hevrosy/neuromorphic-enose-fpga/cadfiles/README.md

# Advanced E-Nose Fluidic Chamber
## Dual-Loop Parametric Measurement Chamber for Gas-Sensor Arrays

**Project:** Neuromorphic e-Nose on FPGA  
**Repository section:** `cadfiles/`  
**CAD model:** `enose_chamber_parametric.scad`  
**Architecture version:** 1.2.4  
**Target application:** Electronic-nose data acquisition, VOC sampling, gas-sensor array stabilization, and machine-learning dataset generation  
**Primary manufacturing method:** FDM 3D printing  
**Target fan:** Sunon EE60201B1 or mechanically compatible high-speed 60 mm axial fan  

---

## 1. Overview

This directory contains the parametric CAD design for a custom fluidic measurement chamber developed as part of the **Neuromorphic e-Nose on FPGA** project. The chamber is designed for repeatable acquisition of gas-sensor time-series data from volatile organic compounds emitted by food samples or other analyte sources.

The chamber is not a simple enclosure. It is a controlled fluidic interface between the physical sample, the gas-sensor array, and the data-acquisition pipeline. Its purpose is to reduce common sources of experimental variability in low-cost electronic-nose systems, including uncontrolled turbulence, stagnant zones, thermal drift, sensor-to-sensor exposure imbalance, vibration transfer, and adsorption memory effects.

The current CAD implementation is provided as a fully parametric OpenSCAD model. It includes the main flow chamber, sensor plate, honeycomb diffuser, aerodynamic lid, fan dome, TPU gaskets, fan-isolation elements, purge plug, vibration-damping washers, and shock-absorbing feet.

---

## 2. Design Motivation

Low-cost electronic-nose systems based on metal-oxide semiconductor gas sensors are highly sensitive to the geometry and dynamics of the measurement chamber. Even when the same sensors and electronics are used, the acquired data can vary significantly depending on airflow, sample position, chamber volume, temperature distribution, and residual contamination from previous measurements.

The chamber was designed to address the following problems:

1. **Poor gas mixing**  
   Box-shaped chambers often create stagnant zones where analyte concentration changes slowly and non-uniformly.

2. **Aerodynamic noise**  
   Turbulent eddies near the sensor surface can create local pressure and concentration fluctuations that appear as noise in the sensor response.

3. **Thermal drift**  
   MQ-series sensors rely on heated metal-oxide surfaces. Excessive or unstable airflow can disturb the thermal equilibrium of the sensing layer and shift the baseline.

4. **Sensor exposure imbalance**  
   If the gas front reaches different sensors at different times or concentrations, the dataset may encode chamber artifacts rather than chemical information.

5. **Memory effect**  
   VOC molecules can adsorb to untreated 3D-printed polymer surfaces and desorb slowly in later runs, contaminating the baseline.

6. **Vibration coupling**  
   Fan-induced vibration can be mechanically transferred to the sensor plate and wiring, increasing analog measurement noise.

The proposed design uses a dual-loop fluidic architecture to separate high-energy internal mixing from low-flow sample extraction and sensor exposure.

---

## 3. System-Level Role in the e-Nose Project

The chamber is the physical front end of the full neuromorphic e-nose pipeline:

```text
Food or analyte sample
        ↓
Headspace vial / sample source
        ↓
Passive sample transport through PTFE tubing
        ↓
Fluidic chamber and gas-sensor array
        ↓
Raw sensor time-series acquisition
        ↓
Baseline correction and preprocessing
        ↓
Delta-based spike encoding
        ↓
SNN training and weight quantization
        ↓
FPGA SNN inference on PYNQ-Z2 / Zynq-7020
```

The chamber is therefore not only a mechanical part. It is a dataset-quality component. Its design affects the signal-to-noise ratio, temporal repeatability, sensor drift, and reliability of the training data used by the spiking neural network.

---

## 4. Fluidic Architecture

The chamber uses a **dual-loop fluidic architecture**:

1. **Primary internal loop**  
   A high-flow internal circulation loop driven by the axial fan. Its role is to rapidly homogenize the air volume inside the chamber.

2. **Secondary sampling loop**  
   A low-flow passive extraction path that transports analyte from an external headspace vial into the chamber through PTFE tubing. Its role is to introduce the sample gas at a controlled rate without disturbing the thermal stability of the sensors.

This separation allows the chamber to combine fast mixing with gentle sensor exposure.

---

## 5. Primary Loop: Internal Mixing and Homogenization

The primary loop is generated by a high-speed axial fan mounted in the upper section of the chamber. Instead of blowing directly onto the sensor array, the fan output is routed through tangential ducts integrated into the aerodynamic lid.

These tangential ducts inject air along the chamber walls, producing a controlled cyclonic flow. The purpose of this flow is to homogenize the chamber volume and reduce concentration gradients.

The design model assumes:

| Parameter | Design Estimate |
|---|---:|
| Main chamber volume | approximately 1.2 L |
| Operating pressure differential | approximately 39 Pa |
| Engineered choke diameter | 6.5 mm |
| Primary internal flow estimate | approximately 40 L/min |
| Approximate chamber volume exchanges | approximately 33 per minute |

These values are analytical design estimates derived from the geometry and simplified fluid-dynamic assumptions. They should be experimentally verified using flow or pressure measurements if used as final metrological data.

---

## 6. Honeycomb Diffuser and Flow Laminarization

Although the primary vortex improves mixing, turbulent flow directly over metal-oxide sensors is undesirable. The chamber therefore includes a **40 mm honeycomb diffuser insert**. The diffuser acts as a geometric flow straightener.

Its purpose is to:

- break the large-scale vortex into many small parallel channels;
- suppress transverse velocity components;
- reduce local turbulence near the sensing surface;
- produce a more uniform cross-flow over the sensor plate;
- improve the repeatability of the transient response.

The OpenSCAD model implements this diffuser as a drop-in honeycomb structure with integrated mounting pillars. The honeycomb geometry is intended to reduce the effective hydraulic diameter of the flow paths and promote more stable flow conditions before the gas reaches the sensors.

---

## 7. Secondary Loop: Passive Sample Extraction

The secondary loop transports analyte from an external headspace vial to the chamber through a chemically inert PTFE tube. This avoids placing the food sample directly on the sensor plate and makes the measurement more repeatable.

The current design documentation assumes:

| Parameter | Design Value |
|---|---:|
| Headspace vial volume | approximately 115 mL |
| PTFE tube internal radius | 1 mm |
| PTFE tube length | approximately 0.4 m |
| Driving pressure differential | approximately 39 Pa |
| Estimated sampling flow | approximately 127 mL/min |
| Approximate vial exchange time | approximately 54 s |

The sampling flow is estimated using the Hagen–Poiseuille equation for laminar flow in a cylindrical tube:

\[
Q = \frac{\Delta P \cdot \pi r^4}{8 \mu L}
\]

where \(\Delta P\) is the pressure differential, \(r\) is the tube radius, \(\mu\) is the dynamic viscosity of air, and \(L\) is the tube length.

A key design feature is the fourth-power dependence on tube radius. Small changes in tube diameter can strongly affect the sampling flow. For this reason, the tubing diameter and length should be kept fixed between experiments.

---

## 8. Sensor Thermodynamics

MQ-series gas sensors use heated metal-oxide surfaces, commonly based on tin dioxide. Their response depends on surface reactions between adsorbed oxygen species and reducing gases. The heater temperature strongly affects adsorption, desorption, surface conductivity, and baseline resistance.

A major risk in electronic-nose chambers is convective cooling of the sensor surface. If the gas flow over the sensing layer is too strong or unstable, the sensor baseline may shift because of thermal effects rather than analyte concentration.

The chamber therefore separates the high-flow mixing loop from the low-flow sample-exposure loop. The primary loop homogenizes the chamber, while the secondary loop introduces sample gas at a restricted flow rate. This helps reduce thermal disturbance of the sensor micro-heaters.

---

## 9. Vibration Isolation

The design includes several TPU-based viscoelastic elements:

- lid gaskets;
- fan isolation gasket;
- fan suspension gasket;
- TPU washers;
- shock-absorbing base feet;
- purge plug.

These components serve two purposes:

1. **Airtight sealing**  
   TPU gaskets improve hermetic sealing between printed rigid parts.

2. **Mechanical decoupling**  
   TPU elements reduce vibration transfer from the fan to the chamber body and sensor plate.

This is important because mechanical vibration can couple into wiring, sensor boards, connectors, and analog front-end electronics.

---

## 10. Surface Passivation and Memory Effect

FDM-printed polymer surfaces are not ideal analytical surfaces. They may contain layer lines, pores, roughness, and chemically active sites. VOC molecules can adsorb to these surfaces and slowly desorb during later measurements, creating a memory effect.

For scientific experiments, the inner surfaces of the chamber should be passivated. A thin layer of chemically resistant, low-outgassing, low-surface-energy coating can reduce adsorption and improve recovery between runs.

Recommended passivation targets:

- internal wall of the main flow chamber;
- internal lid surfaces;
- sample gas pathway;
- surfaces exposed to analyte-rich gas.

The passivation process should be documented in the experimental protocol because it directly affects dataset repeatability.

---

## 11. Purge Protocol

The chamber includes a purge feature that allows rapid removal of residual analyte between experiments. The purge plug can be opened to reduce the aerodynamic impedance and allow high-flow flushing with room air.

A purge cycle is required between measurement runs to:

- remove residual VOCs;
- restore the sensor baseline;
- reduce cross-contamination;
- improve repeatability;
- avoid temporal leakage between sample classes.

A conservative measurement protocol should include a fixed purge duration, even if the analytical estimate suggests fast volume exchange.

Recommended practical purge procedure:

```text
1. Remove or isolate the previous sample.
2. Open the purge path.
3. Run the fan for a fixed purge duration.
4. Monitor sensor baseline recovery.
5. Start the next run only after the baseline stabilizes.
```

For publication-quality experiments, the purge time should be determined experimentally from baseline recovery curves rather than only from theoretical airflow estimates.

---

## 12. CAD Model Structure

The file `enose_chamber_parametric.scad` contains the full parametric chamber model.

The OpenSCAD model supports several rendering and export modes through the `view_mode` parameter:

```scad
view_mode = "print_layout";
```

Available modes:

| Mode | Description |
|---|---|
| `assembly` | Full exploded assembly view |
| `print_layout` | All parts arranged on the build plate |
| `part_base` | Export the main flow chamber base |
| `part_plate` | Export the universal sensor plate |
| `part_diffuser` | Export the honeycomb diffuser |
| `part_lid` | Export the aerodynamic lid |
| `part_dome` | Export the wide-body fan dome |
| `tpu_lid_gaskets` | Export main TPU sealing gaskets |
| `tpu_purge_plug` | Export the ergonomic purge plug |
| `tpu_fan_gasket` | Export the fan isolation gasket |
| `tpu_washers` | Export TPU dome bolt washers |
| `tpu_feet` | Export shock-absorbing base feet |

---

## 13. Main Printed Components

| Component | Function | Suggested Material |
|---|---|---|
| `flow_chamber` | Main 1.2 L chamber body with ports and standoffs | PETG / ABS / ASA |
| `sensor_plate` | Universal perforated plate for sensor mounting | PETG / ABS / ASA |
| `diffuser_insert` | 40 mm honeycomb flow straightener | PETG / ABS / ASA |
| `lid_pro` | Aerodynamic lid with tangential ducts and gasket grooves | PETG / ABS / ASA |
| `fan_dome_ultimate` | Wide-body fan dome with bypass cavity | PETG / ABS / ASA |
| `tpu_lid_gaskets` | Main airtight gaskets | TPU 95A |
| `tpu_purge_plug` | Manual purge valve plug | TPU 95A |
| `tpu_fan_gasket` | Fan vibration isolation gasket | TPU 95A |
| `tpu_washers` | Dome bolt vibration washers | TPU 95A |
| `tpu_feet` | Shock-absorbing chamber feet | TPU 95A |

---

## 14. Key Parametric Dimensions

The current OpenSCAD model uses the following main parameters:

| Parameter | Value | Description |
|---|---:|---|
| `fc_w` | 144 mm | Outer base width |
| `fc_l` | 144 mm | Outer base length |
| `fc_h` | 60 mm | Internal height of primary air column |
| `fc_r` | 15 mm | Outer corner radius |
| `wall_t` | 4.0 mm | Wall thickness |
| `bot_t` | 4.0 mm | Base floor thickness |
| `sp_mount_xy` | 100 mm | Sensor plate mounting hole spacing |
| `fan_size` | 62 mm | Fan footprint with tolerance |
| `fan_hole` | 58 mm | Active fan intake diameter |
| `fan_mount` | 25 mm | Fan mounting hole offset |
| `fan_thickness` | 20 mm | Target fan thickness |
| `tpu_t` | 1.2 mm | Fan isolation gasket thickness |
| `gasket_h` | 3.2 mm | Main gasket groove depth |
| `tol` | 0.2 mm | General print clearance tolerance |

These parameters can be modified to adapt the chamber to other fans, sensor plates, or manufacturing tolerances.

---

## 15. Manufacturing Recommendations

Recommended rigid materials:

- PETG;
- ABS;
- ASA.

Recommended flexible material:

- TPU 95A for gaskets, isolation washers, plug, and feet.

General printing recommendations:

| Parameter | Recommendation |
|---|---|
| Layer height | 0.16–0.24 mm |
| Perimeters | 4 or more |
| Infill | 25–40%, gyroid or cubic |
| Top/bottom layers | 5 or more |
| Rigid parts | PETG / ABS / ASA |
| Gaskets | TPU 95A |
| Supports | Designed to be support-free where possible |

For gas-sensing experiments, airtightness is more important than visual surface quality. Increase wall count if needed.

---

## 16. Bill of Materials

| Category | Item | Quantity | Notes |
|---|---|---:|---|
| Filament | PETG / ABS / ASA | approximately 300 g | Rigid parts |
| Filament | TPU 95A | approximately 10–20 g | Gaskets, washers, plug, feet |
| Fan | Sunon EE60201B1 or compatible 60 mm fan | 1 | High-speed axial fan |
| Inserts | M3 heat-set inserts | 12 pcs | For repeated assembly |
| Bolts | M3 bolts | as required | Lid, dome, diffuser mounting |
| Pneumatic fittings | PC4-M6 or compatible | 1–2 pcs | Sample tubing connection |
| Tubing | PTFE tube, 2 mm ID | approximately 0.4–0.5 m | Sample transport |
| Sealant/coating | Low-outgassing epoxy or compatible coating | as required | Surface passivation |

---

## 17. Assembly Overview

Recommended assembly sequence:

```text
1. Print rigid parts from PETG, ABS, or ASA.
2. Print TPU gaskets, fan gasket, washers, purge plug, and feet.
3. Install M3 heat-set inserts in the base and lid.
4. Mount the sensor plate inside the chamber.
5. Install the honeycomb diffuser above the sensor region.
6. Install the lid gasket and mount the aerodynamic lid.
7. Mount the fan between TPU isolation gaskets.
8. Install the fan dome and TPU washers.
9. Install PTFE tubing and pneumatic fittings.
10. Seal and passivate internal analyte-exposed surfaces if required.
11. Perform leak testing and purge testing.
12. Run baseline stability tests before collecting datasets.
```

---

## 18. Experimental Use

A recommended measurement run includes:

```text
1. Chamber purge
2. Baseline acquisition
3. Sample connection or sample exposure
4. Stabilization interval
5. Active recording interval
6. Sample removal
7. Post-run purge
8. Baseline recovery check
```

Recommended metadata for each run:

| Field | Description |
|---|---|
| `Run_ID` | Unique measurement run identifier |
| `Batch_ID` | Sample batch identifier |
| `Product` | Food or analyte type |
| `True_Class` | Experimental label, e.g. Fresh / Warning / Spoiled |
| `Timestamp` | Acquisition time |
| `Temperature` | Chamber or ambient temperature |
| `Humidity` | Relative humidity |
| `Purge_Time` | Purge duration before run |
| `Baseline_Duration` | Baseline acquisition duration |
| `Recording_Duration` | Active measurement duration |
| `Notes` | Experimental observations |

---

## 19. Integration With the Neuromorphic FPGA Pipeline

The chamber provides the physical data source for the full neuromorphic pipeline:

```text
Chamber measurement
        ↓
Raw sensor values
        ↓
Baseline-corrected values
        ↓
Temporal delta extraction
        ↓
Positive and negative spike channels
        ↓
12-bit spike masks
        ↓
SNN training dataset
        ↓
Quantized weights
        ↓
FPGA SNN inference
```

This makes the chamber an essential part of the system, not only an accessory. Any changes to chamber geometry, tubing length, fan speed, purge procedure, or surface coating may change the dataset distribution and should be documented.

---

## 20. Scientific Notes and Limitations

The current chamber design is based on analytical fluid-dynamic reasoning and parametric CAD implementation. The reported pressure, flow, and exchange-time values should be interpreted as design estimates unless independently measured.

Recommended validation steps:

- measure actual pressure differential;
- measure sample loop flow rate;
- measure purge recovery time;
- record baseline stability over time;
- compare sensor response with and without fan vibration isolation;
- evaluate repeatability across multiple runs;
- evaluate adsorption memory before and after surface passivation.

---

## 21. Future Improvements

Planned or recommended future work:

- experimental airflow validation;
- pressure sensor integration;
- flow sensor integration;
- controlled fan-speed PWM mode;
- replaceable sample vial adapter;
- improved surface passivation protocol;
- temperature-stabilized chamber version;
- CFD simulation of the primary and secondary loops;
- comparison between vortex-only and diffuser-assisted operation;
- full dataset-quality study using real food samples.

---

## 22. Citation

If you use this chamber design in academic or research work, please cite the repository:

```bibtex
@misc{neuromorphic_enose_chamber,
  author = {H. Vrosy},
  title = {Advanced E-Nose Fluidic Chamber for Neuromorphic e-Nose on FPGA},
  year = {2026},
  howpublished = {GitHub repository},
  note = {Parametric dual-loop fluidic chamber for gas-sensor arrays and electronic-nose data acquisition}
}
```

---

# Българска версия

---

## 1. Общо описание

Тази директория съдържа параметричния CAD дизайн на специализирана флуидна измервателна камера, разработена като част от проекта **Neuromorphic e-Nose on FPGA**. Камерата е предназначена за повтаряемо събиране на времеви редове от газови сензори при измерване на летливи органични съединения, отделяни от хранителни проби или други източници на аналит.

Камерата не е просто механична кутия. Тя представлява контролиран флуиден интерфейс между физическата проба, масива от газови сензори и pipeline-а за събиране на данни. Целта ѝ е да намали основните източници на експериментална неопределеност в нискобюджетни електронни носове: неконтролирана турбулентност, мъртви зони, термичен дрейф, неравномерно излагане на сензорите, пренос на вибрации и адсорбционен memory effect.

Текущата CAD реализация е предоставена като напълно параметричен OpenSCAD модел. Той включва основна флуидна камера, сензорна плоча, honeycomb дифузор, аеродинамичен капак, купол за вентилатор, TPU гарнитури, елементи за виброизолация на вентилатора, purge тапа, вибрационни шайби и омекотяващи крачета.

---

## 2. Мотивация на дизайна

Електронните носове, базирани на метал-оксидни газови сензори, са силно чувствителни към геометрията и динамиката на измервателната камера. Дори при използване на едни и същи сензори и електроника, събраните данни могат да се различават значително в зависимост от въздушния поток, позицията на пробата, обема на камерата, температурното разпределение и остатъчното замърсяване от предишни измервания.

Камерата е проектирана да адресира следните проблеми:

1. **Лошо смесване на газовете**  
   Кутиеобразните камери често създават застойни зони, в които концентрацията на аналита се изменя бавно и неравномерно.

2. **Аеродинамичен шум**  
   Турбулентни вихри около повърхността на сензорите могат да създават локални флуктуации на налягането и концентрацията, които се проявяват като шум в сензорния отговор.

3. **Термичен дрейф**  
   MQ сензорите работят чрез нагрети метал-оксидни повърхности. Прекалено силен или нестабилен въздушен поток може да наруши термичното равновесие и да измести baseline-а.

4. **Неравномерно излагане на сензорите**  
   Ако газовият фронт достига различните сензори по различно време или с различна концентрация, dataset-ът може да кодира артефакти от камерата вместо химична информация.

5. **Memory effect**  
   VOC молекули могат да се адсорбират по необработени 3D-принтирани полимерни повърхности и да се освобождават бавно при следващи измервания.

6. **Пренос на вибрации**  
   Вибрациите от вентилатора могат механично да се предадат към сензорната плоча и окабеляването, увеличавайки аналоговия шум.

Предложеният дизайн използва двуконтурна флуидна архитектура, която разделя високоенергийното вътрешно смесване от нискодебитната екстракция на пробата и излагането на сензорите.

---

## 3. Роля в цялостния e-Nose проект

Камерата е физическият входен слой на пълния невроморфен e-nose pipeline:

```text
Хранителна или аналитна проба
        ↓
Headspace vial / съд за проба
        ↓
Пасивен транспорт през PTFE тръба
        ↓
Флуидна камера и газов сензорен масив
        ↓
Събиране на сурови сензорни времеви редове
        ↓
Baseline correction и preprocessing
        ↓
Delta-базирано spike encoding
        ↓
Обучение на SNN и квантизация на теглата
        ↓
FPGA SNN инференция върху PYNQ-Z2 / Zynq-7020
```

Следователно камерата не е само механичен аксесоар. Тя е компонент, който влияе директно върху качеството на dataset-а, signal-to-noise ratio, повторяемостта във времето, дрейфа на сензорите и надеждността на тренировъчните данни за спайковата невронна мрежа.

---

## 4. Флуидна архитектура

Камерата използва **двуконтурна флуидна архитектура**:

1. **Първичен вътрешен контур**  
   Високодебитен вътрешен циркулационен контур, задвижван от аксиален вентилатор. Неговата роля е бърза хомогенизация на въздушния обем вътре в камерата.

2. **Вторичен пробовземен контур**  
   Нискодебитен пасивен път за екстракция, който транспортира аналит от външен headspace съд към камерата чрез PTFE тръба. Неговата роля е да въвежда газовата проба с контролиран дебит, без да нарушава термичната стабилност на сензорите.

Това разделяне позволява камерата да комбинира бързо смесване с меко и стабилно излагане на сензорите.

---

## 5. Първичен контур: вътрешно смесване и хомогенизация

Първичният контур се генерира от високоскоростен аксиален вентилатор, монтиран в горната част на камерата. Вместо да духа директно върху сензорния масив, потокът от вентилатора се насочва през тангенциални канали, интегрирани в аеродинамичния капак.

Тези тангенциални канали инжектират въздуха по стените на камерата и създават контролиран циклонен поток. Целта на този поток е хомогенизация на обема и намаляване на концентрационните градиенти.

Дизайн моделът приема следните стойности:

| Параметър | Проектна оценка |
|---|---:|
| Обем на основната камера | приблизително 1.2 L |
| Работен диференциал на налягането | приблизително 39 Pa |
| Диаметър на геометричния дросел | 6.5 mm |
| Оценен първичен вътрешен дебит | приблизително 40 L/min |
| Приблизителни обмени на обема | приблизително 33 пъти в минута |

Тези стойности са аналитични проектни оценки, получени от геометрията и опростени флуидно-динамични предположения. Ако се използват като крайни метрологични данни, трябва да бъдат експериментално потвърдени чрез измерване на дебит или налягане.

---

## 6. Honeycomb дифузор и ламинаризация

Въпреки че първичният вихър подобрява смесването, директната турбулентност върху метал-оксидните сензори е нежелана. Затова камерата включва **40 mm honeycomb diffuser insert**, който действа като геометричен изправител на потока.

Неговата цел е да:

- раздели големия вихров поток на множество малки паралелни канали;
- потисне напречните компоненти на скоростта;
- намали локалната турбулентност около сензорната повърхност;
- създаде по-равномерен cross-flow над сензорната плоча;
- подобри повторяемостта на преходния сензорен отговор.

OpenSCAD моделът реализира дифузора като drop-in honeycomb структура с интегрирани монтажни колони. Геометрията намалява ефективния хидравличен диаметър на пътищата на потока и подпомага по-стабилни условия преди газът да достигне сензорите.

---

## 7. Вторичен контур: пасивна екстракция на пробата

Вторичният контур транспортира аналит от външен headspace съд към камерата чрез химически инертна PTFE тръба. Това избягва директното поставяне на хранителната проба върху сензорната плоча и прави измерването по-повтаряемо.

Текущата проектна документация приема:

| Параметър | Проектна стойност |
|---|---:|
| Обем на headspace съда | приблизително 115 mL |
| Вътрешен радиус на PTFE тръбата | 1 mm |
| Дължина на PTFE тръбата | приблизително 0.4 m |
| Движещ диференциал на налягането | приблизително 39 Pa |
| Оценен дебит на пробовземане | приблизително 127 mL/min |
| Приблизително време за обмен на съда | приблизително 54 s |

Дебитът се оценява чрез уравнението на Хаген–Поазьой за ламинарен поток в цилиндрична тръба:

\[
Q = \frac{\Delta P \cdot \pi r^4}{8 \mu L}
\]

където \(\Delta P\) е диференциалът на налягането, \(r\) е радиусът на тръбата, \(\mu\) е динамичният вискозитет на въздуха, а \(L\) е дължината на тръбата.

Ключов аспект е зависимостта от четвърта степен на радиуса. Малки промени в диаметъра на тръбата могат силно да променят дебита. Затова диаметърът и дължината на тръбата трябва да се запазват постоянни между експериментите.

---

## 8. Термодинамика на сензорите

MQ газовите сензори използват нагрети метал-оксидни повърхности, често базирани на калаен диоксид. Техният отговор зависи от повърхностни реакции между адсорбирани кислородни видове и редуциращи газове. Температурата на нагревателя силно влияе върху адсорбцията, десорбцията, повърхностната проводимост и baseline съпротивлението.

Основен риск при електронните носове е конвективното охлаждане на сензорната повърхност. Ако потокът над чувствителния слой е прекалено силен или нестабилен, baseline-ът може да се измести поради термични ефекти, а не поради концентрация на аналита.

Затова камерата разделя високодебитното смесване от нискодебитното излагане на пробата. Първичният контур хомогенизира камерата, а вторичният контур въвежда пробовия газ с ограничен дебит. Това помага за намаляване на термичното смущение върху микронагревателите на сензорите.

---

## 9. Виброизолация

Дизайнът включва няколко TPU-базирани вискоеластични елемента:

- гарнитури за капака;
- гарнитура за изолация на вентилатора;
- окачваща гарнитура за вентилатора;
- TPU шайби;
- омекотяващи крачета;
- purge тапа.

Тези компоненти имат две основни функции:

1. **Херметизация**  
   TPU гарнитурите подобряват уплътняването между твърдите принтирани детайли.

2. **Механично декуплиране**  
   TPU елементите намаляват преноса на вибрации от вентилатора към корпуса и сензорната плоча.

Това е важно, защото механичните вибрации могат да се прехвърлят към проводници, сензорни платки, конектори и аналогова входна електроника.

---

## 10. Пасивация на повърхностите и memory effect

FDM-принтираните полимерни повърхности не са идеални аналитични повърхности. Те могат да съдържат слоеви линии, микропори, грапавини и химически активни места. VOC молекули могат да се адсорбират по тези повърхности и да се десорбират бавно при следващи измервания, създавайки memory effect.

За научни експерименти вътрешните повърхности на камерата трябва да бъдат пасивирани. Тънък слой химически устойчиво, нискоизпаримо покритие с ниска повърхностна енергия може да намали адсорбцията и да подобри възстановяването между runs.

Препоръчителни зони за пасивация:

- вътрешна стена на основната флуидна камера;
- вътрешни повърхности на капака;
- пътят на пробовия газ;
- повърхности, изложени на богат на аналит газ.

Процесът на пасивация трябва да се документира в експерименталния протокол, защото влияе пряко върху повторяемостта на dataset-а.

---

## 11. Purge протокол

Камерата включва purge функция, която позволява бързо премахване на остатъчния аналит между експериментите. Purge тапата може да се отвори, за да се намали аеродинамичният импеданс и да се позволи високодебитно промиване със стаен въздух.

Purge цикълът е необходим за:

- премахване на остатъчни VOCs;
- възстановяване на baseline-а;
- намаляване на cross-contamination;
- подобряване на повторяемостта;
- избягване на temporal leakage между класове проби.

Препоръчителна практическа процедура:

```text
1. Премахване или изолиране на предходната проба.
2. Отваряне на purge пътя.
3. Работа на вентилатора за фиксирано purge време.
4. Наблюдение на възстановяването на baseline-а.
5. Стартиране на следващия run само след стабилизиране на baseline-а.
```

За публикационни експерименти purge времето трябва да се определи експериментално от кривите на възстановяване на baseline-а, а не само от теоретични оценки на въздушния обмен.

---

## 12. Структура на CAD модела

Файлът `enose_chamber_parametric.scad` съдържа пълния параметричен модел на камерата.

OpenSCAD моделът поддържа няколко режима за визуализация и export чрез параметъра `view_mode`:

```scad
view_mode = "print_layout";
```

Налични режими:

| Режим | Описание |
|---|---|
| `assembly` | Пълна exploded assembly визуализация |
| `print_layout` | Всички детайли подредени върху build plate |
| `part_base` | Export на основната флуидна камера |
| `part_plate` | Export на универсалната сензорна плоча |
| `part_diffuser` | Export на honeycomb дифузора |
| `part_lid` | Export на аеродинамичния капак |
| `part_dome` | Export на широкия купол за вентилатора |
| `tpu_lid_gaskets` | Export на основните TPU гарнитури |
| `tpu_purge_plug` | Export на ергономичната purge тапа |
| `tpu_fan_gasket` | Export на гарнитурата за изолация на вентилатора |
| `tpu_washers` | Export на TPU шайби за болтовете на купола |
| `tpu_feet` | Export на омекотяващи TPU крачета |

---

## 13. Основни принтирани компоненти

| Компонент | Функция | Препоръчителен материал |
|---|---|---|
| `flow_chamber` | Основно тяло на камерата с приблизителен обем 1.2 L | PETG / ABS / ASA |
| `sensor_plate` | Универсална перфорирана плоча за сензори | PETG / ABS / ASA |
| `diffuser_insert` | 40 mm honeycomb изправител на потока | PETG / ABS / ASA |
| `lid_pro` | Аеродинамичен капак с тангенциални канали | PETG / ABS / ASA |
| `fan_dome_ultimate` | Wide-body купол за вентилатора | PETG / ABS / ASA |
| `tpu_lid_gaskets` | Основни херметизиращи гарнитури | TPU 95A |
| `tpu_purge_plug` | Ръчна purge тапа | TPU 95A |
| `tpu_fan_gasket` | Гарнитура за виброизолация на вентилатора | TPU 95A |
| `tpu_washers` | Виброизолиращи шайби за купола | TPU 95A |
| `tpu_feet` | Омекотяващи крачета | TPU 95A |

---

## 14. Основни параметрични размери

Текущият OpenSCAD модел използва следните основни параметри:

| Параметър | Стойност | Описание |
|---|---:|---|
| `fc_w` | 144 mm | Външна ширина на основата |
| `fc_l` | 144 mm | Външна дължина на основата |
| `fc_h` | 60 mm | Вътрешна височина на първичния въздушен стълб |
| `fc_r` | 15 mm | Радиус на външните ъгли |
| `wall_t` | 4.0 mm | Дебелина на стените |
| `bot_t` | 4.0 mm | Дебелина на дъното |
| `sp_mount_xy` | 100 mm | Разстояние между монтажните отвори на сензорната плоча |
| `fan_size` | 62 mm | Footprint на вентилатора с толеранс |
| `fan_hole` | 58 mm | Активен диаметър на входа на вентилатора |
| `fan_mount` | 25 mm | Отместване на монтажните отвори на вентилатора |
| `fan_thickness` | 20 mm | Целева дебелина на вентилатора |
| `tpu_t` | 1.2 mm | Дебелина на fan isolation gasket |
| `gasket_h` | 3.2 mm | Дълбочина на каналите за гарнитури |
| `tol` | 0.2 mm | Общ толеранс за 3D печат |

Тези параметри могат да се променят за адаптация към други вентилатори, сензорни плочи или производствени толеранси.

---

## 15. Препоръки за производство

Препоръчителни твърди материали:

- PETG;
- ABS;
- ASA.

Препоръчителен гъвкав материал:

- TPU 95A за гарнитури, шайби, purge тапа и крачета.

Общи препоръки за печат:

| Параметър | Препоръка |
|---|---|
| Layer height | 0.16–0.24 mm |
| Perimeters | 4 или повече |
| Infill | 25–40%, gyroid или cubic |
| Top/bottom layers | 5 или повече |
| Твърди детайли | PETG / ABS / ASA |
| Гарнитури | TPU 95A |
| Supports | Дизайнът е предвиден да е support-free, когато е възможно |

При експерименти с газови сензори херметичността е по-важна от визуалното качество на повърхността. При нужда увеличете броя на стените.

---

## 16. Bill of Materials

| Категория | Елемент | Количество | Бележки |
|---|---|---:|---|
| Филамент | PETG / ABS / ASA | приблизително 300 g | Твърди детайли |
| Филамент | TPU 95A | приблизително 10–20 g | Гарнитури, шайби, тапа, крачета |
| Вентилатор | Sunon EE60201B1 или съвместим 60 mm вентилатор | 1 | Високоскоростен аксиален вентилатор |
| Вложки | M3 heat-set inserts | 12 бр. | За многократен монтаж |
| Болтове | M3 bolts | според нуждите | Капак, купол, дифузор |
| Пневматични фитинги | PC4-M6 или съвместими | 1–2 бр. | Свързване на пробовата тръба |
| Тръба | PTFE tube, 2 mm ID | приблизително 0.4–0.5 m | Транспорт на пробата |
| Покритие | Нискоизпарима епоксидна смола или съвместимо покритие | според нуждите | Пасивация на повърхностите |

---

## 17. Общ монтаж

Препоръчителна последователност за монтаж:

```text
1. Принтирайте твърдите детайли от PETG, ABS или ASA.
2. Принтирайте TPU гарнитурите, fan gasket, шайбите, purge тапата и крачетата.
3. Инсталирайте M3 heat-set inserts в основата и капака.
4. Монтирайте сензорната плоча в камерата.
5. Поставете honeycomb дифузора над сензорната зона.
6. Поставете гарнитурата на капака и монтирайте аеродинамичния капак.
7. Монтирайте вентилатора между TPU изолационните гарнитури.
8. Монтирайте fan dome и TPU шайбите.
9. Инсталирайте PTFE тръбата и пневматичните фитинги.
10. Уплътнете и пасивирайте вътрешните повърхности, ако е необходимо.
11. Извършете leak test и purge test.
12. Изпълнете baseline stability tests преди събиране на dataset.
```

---

## 18. Експериментална употреба

Препоръчителен measurement run включва:

```text
1. Purge на камерата
2. Baseline acquisition
3. Свързване или излагане на пробата
4. Интервал за стабилизиране
5. Активен запис
6. Премахване на пробата
7. Post-run purge
8. Проверка за възстановяване на baseline-а
```

Препоръчителни metadata полета за всеки run:

| Поле | Описание |
|---|---|
| `Run_ID` | Уникален идентификатор на измерването |
| `Batch_ID` | Идентификатор на партидата |
| `Product` | Тип храна или аналит |
| `True_Class` | Експериментален етикет, например Fresh / Warning / Spoiled |
| `Timestamp` | Време на измерването |
| `Temperature` | Температура в камерата или средата |
| `Humidity` | Относителна влажност |
| `Purge_Time` | Продължителност на purge преди run |
| `Baseline_Duration` | Продължителност на baseline acquisition |
| `Recording_Duration` | Продължителност на активния запис |
| `Notes` | Експериментални бележки |

---

## 19. Интеграция с невроморфния FPGA pipeline

Камерата осигурява физическия източник на данни за целия невроморфен pipeline:

```text
Измерване в камерата
        ↓
Сурови сензорни стойности
        ↓
Baseline-corrected стойности
        ↓
Извличане на времеви delta промени
        ↓
Положителни и отрицателни spike канали
        ↓
12-битови spike masks
        ↓
Dataset за SNN обучение
        ↓
Квантизирани тегла
        ↓
FPGA SNN инференция
```

Това прави камерата съществена част от системата, а не само аксесоар. Всяка промяна в геометрията, дължината на тръбата, скоростта на вентилатора, purge процедурата или повърхностното покритие може да промени разпределението на dataset-а и трябва да бъде документирана.

---

## 20. Научни бележки и ограничения

Текущият дизайн на камерата е базиран на аналитични флуидно-динамични оценки и параметрична CAD реализация. Посочените стойности за налягане, дебит и време за обмен трябва да се интерпретират като проектни оценки, освен ако не са независимо измерени.

Препоръчителни валидационни стъпки:

- измерване на реалния диференциал на налягането;
- измерване на дебита във вторичния контур;
- измерване на purge recovery time;
- запис на baseline stability във времето;
- сравнение на сензорен отговор със и без виброизолация;
- оценка на повторяемостта между runs;
- оценка на memory effect преди и след пасивация.

---

## 21. Бъдещи подобрения

Планирани или препоръчителни бъдещи разработки:

- експериментална airflow валидация;
- интеграция на сензор за налягане;
- интеграция на flow sensor;
- PWM контрол на вентилатора;
- сменяем адаптер за sample vial;
- подобрен протокол за пасивация;
- версия с температурна стабилизация;
- CFD симулация на първичния и вторичния контур;
- сравнение между vortex-only и diffuser-assisted режим;
- пълно изследване на качеството на dataset-а с реални хранителни проби.
