hevrosy/neuromorphic-enose-fpga/docs/06_experiments.md

# Experiments

## Baselines
- Simple ML baseline on CPU: Logistic Regression / MLP (optional)
- SNN CPU (golden) vs SNN FPGA

## Metrics
- Accuracy/F1 per class
- Latency: end-to-end per window
- Resource usage from Vivado
- (Optional) Power

## Ablations
- Without T/RH vs with T/RH
- Different encoder thresholds
- Nh = 16/32/64
- W = 5/10/20 seconds
