hevrosy/neuromorphic-enose-fpga/(commit log)

2026-01-15 Commit 1: dataset protocol + DAQ skeleton + preprocess + delta encoder + golden SNN
2026-01-16 Fix: align encoder threshold key with feature name (gas_resistance_ohm)
    [enose_default.yaml]
2026-01-16 Commit 5: AXI contract + FPGA emulator + overlay driver facade
2026-02-20 Phase 0+1: Overlay 0 stub — RTL, bitstream, PYNQ validation (3/3 PASSED)
    Phase 0 — FPGA Preparation:
    - Bit-exact verification: torch → golden → emulator agree
    - .coe weight files generated for BRAM init
    - AXI-Lite register map documented (0x00-0x34)
    - AXI-Stream spike word format defined ([11:0] channels)
    Phase 1 — Overlay 0 (DMA Stub Accelerator):
    - enose_accel_stub.v: single-file RTL with AXI-Lite slave + AXI-Stream
    receiver + popcount accumulator + threshold classifier
    - tb_enose_accel_stub.v: testbench with negedge timing (v7, 3/3 sim PASSED)
    - build_overlay0.tcl: automated IP packaging (ipx::create_core) + block
    design (Zynq PS7 + AXI DMA + custom IP) + HDL wrapper genera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
2026-02-22 Add enose chamber CAD files for 3D printabe parametric enose chamber
    [enose_chamber_parametric.scad]
2026-02-22 Еnose chamber update
    [enose_chamber_parametric.scad]
2026-02-22 Еnose chamber - added gaskets
    [enose_chamber_parametric.scad]
2026-02-23 Еnose chamber - small fixes
    [enose_chamber_parametric.scad]
2026-02-23 Еnose chamber - fix typo
    [enose_chamber_parametric.scad]
2026-02-23 Еnose chamber - Add README
2026-02-24 Еnose chamber - Final v1
    [enose_chamber_parametric.scad]
2026-02-24 Update BOM quantities for filament materials
    Fix typo
2026-02-24 Еnose chamber - Fix for fan cover
    [enose_chamber_parametric.scad]
2026-02-24 Еnose chamber - Final ajustments
    [enose_chamber_parametric.scad]
2026-02-25 Add project overview for neuromorphic FPGA research
    Added detailed project overview for neuromorphic FPGA-based electronic nose, including research objectives, scientific motivation, technical contributions, experimental framework, performance evaluation plan, dissertation integration, future research directions, target impact, and repository role.
2026-03-18 Enhance README with comprehensive project details
    Expanded the README with detailed sections on system design, functionality, and performance metrics for the fluidic chamber used in gas sensor applications.
2026-03-18 Update e-nose chamber to version 1.2.4 with DFM
    [enose_chamber_parametric.scad]
2026-03-25 Expand README with project overview and instructions
    Added comprehensive project details, including system architecture, sensor modalities, algorithmic solutions, operational instructions, and telemetry diagnostics for the Edge AI Electronic Nose (E-Nose) project.
